lu121314/llama_acc/board/runtime/data/README.md

此目录有tokenizer、模型manifest及许可，不包含权重。
请将本版core0.bin和core1.bin放到这里；网盘信息填写在压缩包项目根目录的“权重下载地址.txt”。
