lu121314/llama_acc/report/zu7cg_llama_fpga_handoff.md

# ZU7CG Llama FPGA 项目续接提示词

请接续我的 ZU7CG 双核双DDR Llama FPGA 项目，按本次任务完成开发、验证或交付。先读取现有工程和证据，再行动；对已有授权自主推进，需要我决策时说明具体问题。

## 工作区与入口

- 工作区：`/mnt/data/llama_32_FPGA`。本次所有新文件、日志、补丁和工程都放在 `Version1/`。
- 首先读取：`/mnt/data/llama_32_FPGA/Version1/skills/zu7cg-llama-fpga/SKILL.md`，按任务选择其中的工程索引、硬件流程或PYNQ参考文件。
- 核对 `Version1/PROJECTS.md`、`Version1/vivado_prj/local_rebuild_20261031/current_projects.json`，并按任务检查目标工程的配置、manifest和独立验收记录。
- 上游参考：`llama-fpga/`；旧板级工程：`FPGA_prj/llama32_zu7cg/`；原模型导出/运行工程：`PYTHON_prj/`。保留这些参考。

## 当前基线

以下为截至2026-11-02的交接快照，执行时核对当前文件：

- 已有 Llama3.2-3B 的1024/8192上下文、187.5/250MHz四种版本，四份完整远端Vivado工程均已拷回本机；具体完整副本位置见Skill的工程索引。
- 标准Vivado入口位于 `Version1/vivado_prj/local_rebuild_20261031/`，命名示例为 `llama32_3b_ctx8192_250mhz`。两个1024标准入口与其完整远端副本目录不同，勿混淆。
- 两个8K版本已有接受的实现和配套bit/HWH；最终物理结果来自选定候选DCP。不要仅凭managed `impl_2` 的进度判定最终结果。
- 新8K版本尚未完成板端推理验证。旧版本的单次、重复文本日志不能替代新bit的板端验证。
- 8K权重已生成，两个时钟共用一套完整资源：`core0.bin`、`core1.bin`、模型manifest和tokenizer。每核镜像为2,063,458,304字节；原1024镜像不能直接用于8K布局。共享目录须在运行配置中正确引用。
- 早先复位/BOS排查有条件性V scale残留证据，后来普通文本重复测试也曾通过；唯一根因未闭合，候选修复未应用到生产源。查原始证据后再判断，不把猜测当成已修复或普遍失效。

## 必须遵守的修改约束

1. 保留现有模型、上下文、时钟版本和方案；不删除远端工程、候选、报告、日志。替换本机副本前保留旧目录。
2. 工程按 `模型_ctx上下文_时钟频率` 命名。尽量保持与上游LLaMA2加速器的结构一致，只做完成目标所需的修改。
3. 命名、目录重构、拷贝和纯时钟变体不改RTL逻辑。模型或上下文变更优先修改Scala并生成RTL，在独立变体中保持Scala、RTL、IP、内存布局、权重和运行配置一致。
4. 防过度防御：对几乎不会发生的边界/并发问题，先说明发生条件、概率依据或未知之处，经我确认后再加代码；严禁为了“理论上更稳”膨胀实现。已有实际接口约束和内存预留检查继续保留。
5. 按修改范围使用局部模块仿真与接口时序验证，不主动运行全加速器仿真。测试通过后进入本次任务所需的综合与实现，不无依据扩大验证或重复启动布局布线。
6. 查询、拷贝或打包现有合格结果时，使用已有结果；不要顺带启动新构建。时序通过后从已验收DCP生成bit，不再为重复确认重跑实现。
7. 保留远端快速创建工程脚本。远端凭据仅从 `Version1/Agent.md` 通过现有 `scripts/remote_session.py` 读取，不输出到日志、提示词或交付包。开始构建前检查服务器任务，不中断其他作业；读取日志超时不能直接认定后台作业失败或重复提交。
8. 用户通过板卡Jupyter终端手动执行命令；Vivado服务器不是板卡。给出可直接执行的终端命令，使用板卡现有PYNQ venv。完整部署已复制后的常规小更新优先提供补丁。

## 硬件验证与交付要求

- 先明确目标版本及必要差异，再验证受影响的接口、握手/背压、reset、tag/last、地址和计数；涉及浮点/FIFO IP时核对真实端口与延迟，说明仿真是否使用替身。
- 硬件变更通过局部验证后，才执行所需综合与布局布线。保留来源、脚本、日志和失败候选。
- 验收覆盖setup、hold、pulse、路由、DRC、bus skew及真实MIG MinSkew。当前配置需覆盖18组bus skew和22条Fast/Slow MinSkew；不得关闭检查或放宽约束制造通过。
- MinSkew等关键证据需在真实路由会话中采集并绑定DCP哈希；重开DCP后的空报告不能当成通过。自动CDC告警按实际路径复核，不伪称全部告警清零。
- bit、HWH、manifest须与同一接受结果配套。独立验收JSON与导出manifest分工不同，不手动翻转 `timing_verified` 代替验证。
- 完整工程回传需全文件清单/大小/哈希及本机Vivado引用检查。明确交付的是完整远端工程，还是XPR加DCP。

## PYNQ运行要求

- 既有板卡环境为PYNQ 4.0、Python 3.12.3、aarch64，常用解释器为 `/usr/local/share/pynq-venv/bin/python3`；先核对实际环境。离线依赖匹配该架构与版本。
- 日常运行打印关键步骤，用进度条和百分比显示权重上传；不做权重哈希与DDR回读。`test/` 保留带详细日志的诊断程序，允许其中保留传输校验；`tests/` 为主机测试。
- 保留终端Prompt/Chat、UI、多语言输入输出、最大输出调节和性能指标。区分权重初始化时间、首token延迟、总生成用时、decode速度与整体速度，不用包含权重上传的总耗时替代推理时间。
- 保留资源大小/布局、硬件配套和PS内存预留检查。PS模型池为 `0x800000000` 起的2GiB启动期独占 `no-map`，不能绕过检查向Linux使用的内存写入。
- 上下文预算包含模板、历史和当前输入；当前约束为 `输入token数 + max_new_tokens - 1 <= context_tokens`，不能只改UI限制宣称硬件扩容。
- 板端先短文本，再同进程重复相同prompt、两个不同prompt及所需长上下文覆盖。保存输入与输出token ID、首次不同位置和日志，区分软复位与重下载Overlay/权重。

## 完成标准

完成本次已授权范围，不仅给计划或宣布已提交后台任务。说明修改了什么、验证了什么、仍有哪些未验证结论；区分源代码、局部仿真、实现时序、文件交付和板端功能。

给出准确的本机绝对路径、运行命令或补丁应用命令，并更新对应工程索引和验证记录。关键阻塞或失败如实说明，不用旧日志代替新结果。

## 本次任务（使用前填写）

目标版本：〔模型 / 上下文 / 时钟〕

具体任务：〔需要完成的修改、验证、查询或交付〕

完成后交付：〔文件、工程、bit/HWH、报告或板端命令〕
