lu121314/llama_acc/src/rtl/compute/AddEngineNew_3.v

// Generator : SpinalHDL v1.10.2a    git head : a348a60b7e8b6a455c72e1536ec3d74a2ea16935
// Component : DataPath_xN

`timescale 1ns/1ps

module AddEngineNew_3 (
  input  wire          mulRes_tvalid,
  output wire          mulRes_tready,
  input  wire [511:0]  mulRes_tdata,
  input  wire          resAdd_tvalid,
  output wire          resAdd_tready,
  input  wire [511:0]  resAdd_tdata,
  output wire          vecOut_tvalid,
  output wire [511:0]  vecOut_tdata,
  output wire [5:0]    vecOut_tuser,
  output wire          scalarOut_tvalid,
  output wire          scalarOut_tlast,
  output wire [15:0]   scalarOut_tdata,
  output wire [5:0]    scalarOut_tuser,
  input  wire          cfg_tvalid,
  output wire          cfg_tready,
  input  wire [31:0]   cfg_tdata,
  output wire [5:0]    postCfgTag,
  input  wire          popVldNext,
  input  wire          clk_1_clk,
  input  wire          clk_1_resetn
);

  wire                fifoCtrl_io_push_valid;
  wire       [511:0]  fifoCtrl_io_push_payload;
  wire                fifoCtrl_io_pop_ready;
  wire       [511:0]  fifoCtrl_rdPort_rsp;
  reg        [511:0]  t_1_spinal_port1;
  wire                fifoCtrl_io_push_ready;
  wire                fifoCtrl_io_pop_valid;
  wire       [511:0]  fifoCtrl_io_pop_payload;
  wire       [5:0]    fifoCtrl_io_occupancy;
  wire       [5:0]    fifoCtrl_io_availability;
  wire                fifoCtrl_rdPort_cmd_valid;
  wire       [4:0]    fifoCtrl_rdPort_cmd_payload;
  wire                fifoCtrl_wrPort_valid;
  wire       [4:0]    fifoCtrl_wrPort_payload_address;
  wire       [511:0]  fifoCtrl_wrPort_payload_data;
  wire                addLogic_a_0_add_ip_m_axis_result_tvalid;
  wire       [15:0]   addLogic_a_0_add_ip_m_axis_result_tdata;
  wire                addLogic_a_1_add_ip_m_axis_result_tvalid;
  wire       [15:0]   addLogic_a_1_add_ip_m_axis_result_tdata;
  wire                addLogic_a_2_add_ip_m_axis_result_tvalid;
  wire       [15:0]   addLogic_a_2_add_ip_m_axis_result_tdata;
  wire                addLogic_a_3_add_ip_m_axis_result_tvalid;
  wire       [15:0]   addLogic_a_3_add_ip_m_axis_result_tdata;
  wire                addLogic_a_4_add_ip_m_axis_result_tvalid;
  wire       [15:0]   addLogic_a_4_add_ip_m_axis_result_tdata;
  wire                addLogic_a_5_add_ip_m_axis_result_tvalid;
  wire       [15:0]   addLogic_a_5_add_ip_m_axis_result_tdata;
  wire                addLogic_a_6_add_ip_m_axis_result_tvalid;
  wire       [15:0]   addLogic_a_6_add_ip_m_axis_result_tdata;
  wire                addLogic_a_7_add_ip_m_axis_result_tvalid;
  wire       [15:0]   addLogic_a_7_add_ip_m_axis_result_tdata;
  wire                addLogic_a_8_add_ip_m_axis_result_tvalid;
  wire       [15:0]   addLogic_a_8_add_ip_m_axis_result_tdata;
  wire                addLogic_a_9_add_ip_m_axis_result_tvalid;
  wire       [15:0]   addLogic_a_9_add_ip_m_axis_result_tdata;
  wire                addLogic_a_10_add_ip_m_axis_result_tvalid;
  wire       [15:0]   addLogic_a_10_add_ip_m_axis_result_tdata;
  wire                addLogic_a_11_add_ip_m_axis_result_tvalid;
  wire       [15:0]   addLogic_a_11_add_ip_m_axis_result_tdata;
  wire                addLogic_a_12_add_ip_m_axis_result_tvalid;
  wire       [15:0]   addLogic_a_12_add_ip_m_axis_result_tdata;
  wire                addLogic_a_13_add_ip_m_axis_result_tvalid;
  wire       [15:0]   addLogic_a_13_add_ip_m_axis_result_tdata;
  wire                addLogic_a_14_add_ip_m_axis_result_tvalid;
  wire       [15:0]   addLogic_a_14_add_ip_m_axis_result_tdata;
  wire                addLogic_a_15_add_ip_m_axis_result_tvalid;
  wire       [15:0]   addLogic_a_15_add_ip_m_axis_result_tdata;
  wire                addLogic_a_16_add_ip_m_axis_result_tvalid;
  wire       [15:0]   addLogic_a_16_add_ip_m_axis_result_tdata;
  wire                addLogic_a_17_add_ip_m_axis_result_tvalid;
  wire       [15:0]   addLogic_a_17_add_ip_m_axis_result_tdata;
  wire                addLogic_a_18_add_ip_m_axis_result_tvalid;
  wire       [15:0]   addLogic_a_18_add_ip_m_axis_result_tdata;
  wire                addLogic_a_19_add_ip_m_axis_result_tvalid;
  wire       [15:0]   addLogic_a_19_add_ip_m_axis_result_tdata;
  wire                addLogic_a_20_add_ip_m_axis_result_tvalid;
  wire       [15:0]   addLogic_a_20_add_ip_m_axis_result_tdata;
  wire                addLogic_a_21_add_ip_m_axis_result_tvalid;
  wire       [15:0]   addLogic_a_21_add_ip_m_axis_result_tdata;
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
  reg                 dotCtrl_accCntOvf_delay_20;
  reg                 dotCtrl_accCntOvf_delay_21;
  reg                 dotCtrl_accCntOvf_delay_22;
  reg                 dotCtrl_accCntOvf_delay_23;
  reg                 dotCtrl_accCntOvf_delay_24;
  reg                 dotCtrl_accCntOvf_delay_25;
  reg                 dotCtrl_accCntOvf_delay_26;
  reg                 dotCtrl_accCntOvf_delay_27;
  reg                 dotCtrl_accCntOvf_delay_28;
  reg                 dotCtrl_accCntOvf_delay_29;
  reg                 dotCtrl_accCntOvf_delay_30;
  reg                 dotCtrl_accCntOvf_delay_31;
  reg                 dotCtrl_accCntOvf_delay_32;
  reg                 dotCtrl_accCntOvf_delay_33;
  reg                 dotCtrl_accCntOvf_delay_34;
  reg                 dotCtrl_accCntOvf_delay_35;
  reg                 dotCtrl_accCntOvfDly;
  reg                 dotCtrl_accCntOvf_delay_1_1;
  reg                 dotCtrl_accCntOvf_delay_2_1;
  reg                 dotCtrl_accCntOvf_delay_3_1;
  reg                 dotCtrl_accCntOvf_delay_4_1;
  reg                 dotCtrl_accCntOvf_delay_5_1;
  reg                 dotCtrl_accCntOvf_delay_6_1;
  reg                 dotCtrl_accCntOvf_delay_7_1;
  reg                 dotCtrl_accCntOvf_delay_8_1;
  reg                 dotCtrl_accCntOvf_delay_9_1;
  reg                 dotCtrl_accCntOvf_delay_10_1;
  reg                 dotCtrl_accCntOvf_delay_11_1;
  reg                 dotCtrl_accCntOvf_delay_12_1;
  reg                 dotCtrl_accCntOvf_delay_13_1;
  reg                 dotCtrl_accCntOvf_delay_14_1;
  reg                 dotCtrl_accCntOvf_delay_15_1;
  reg                 dotCtrl_accCntOvf_delay_16_1;
  reg                 dotCtrl_accCntOvf_delay_17_1;
  reg                 dotCtrl_accCntOvf_delay_18_1;
  reg                 dotCtrl_accCntOvf_delay_19_1;
  reg                 dotCtrl_accCntOvf_delay_20_1;
  reg                 dotCtrl_accCntOvf_delay_21_1;
  reg                 dotCtrl_accCntOvf_delay_22_1;
  reg                 dotCtrl_accCntOvf_delay_23_1;
  reg                 dotCtrl_accCntOvf_delay_24_1;
  reg                 dotCtrl_accCntOvf_delay_25_1;
  reg                 dotCtrl_accCntOvf_delay_26_1;
  reg                 dotCtrl_accCntOvf_delay_27_1;
  reg                 dotCtrl_accCntOvf_delay_28_1;
  reg                 dotCtrl_accCntOvf_delay_29_1;
  reg                 dotCtrl_accCntOvf_delay_30_1;
  reg        [31:0]   fAxpyCtrl_cfgPayload;
  (* max_fanout = 100 *) reg                 fAxpyCtrl_cfgVld;
  wire                fAxpyCtrl_psumPopEn;
  wire                fAxpyCtrl_psumPushEn;
  wire                fAxpyCtrl_enMulResCntNext;
  reg                 fAxpyCtrl_enMulResCnt;
  reg        [6:0]    fAxpyCtrl_muResCnt_0;
  reg        [16:0]   fAxpyCtrl_muResCnt_1;
  reg                 fAxpyCtrl_mulResCntOvf_0;
  reg                 fAxpyCtrl_mulResCntOvf_1;
  reg                 fAxpyCtrl_mulResCntOvfReduce;
  reg        [6:0]    t_fAxpyCtrl_muResCnt_0;
  reg        [16:0]   t_fAxpyCtrl_muResCnt_1;
  wire                t_fAxpyCtrl_mulResCntOvf_0;
  wire                t_fAxpyCtrl_mulResCntOvf_1;
  reg                 fAxpyCtrl_mulResCntLastZero;
  reg                 fAxpyCtrl_mulResCntLastZeroNext;
  reg                 fAxpyCtrl_mulResCntLastNotZero;
  reg                 fAxpyCtrl_mulResCntLastNotZeroNext;
  reg                 fAxpyCtrl_enMulResCnt_delay_1;
  reg                 fAxpyCtrl_enMulResCnt_delay_2;
  reg                 fAxpyCtrl_enMulResCnt_delay_3;
  reg                 fAxpyCtrl_enMulResCnt_delay_4;
  reg                 fAxpyCtrl_enMulResCnt_delay_5;
  reg                 fAxpyCtrl_enAddOutCnt;
  reg                 fAxpyCtrl_mulResCntOvf_0_delay_1;
  reg                 fAxpyCtrl_mulResCntOvf_0_delay_2;
  reg                 fAxpyCtrl_mulResCntOvf_0_delay_3;
  reg                 fAxpyCtrl_mulResCntOvf_0_delay_4;
  reg                 fAxpyCtrl_mulResCntOvf_0_delay_5;
  reg                 fAxpyCtrl_addOutCntOvf_0;
  reg                 fAxpyCtrl_mulResCntOvf_1_delay_1;
  reg                 fAxpyCtrl_mulResCntOvf_1_delay_2;
  reg                 fAxpyCtrl_mulResCntOvf_1_delay_3;
  reg                 fAxpyCtrl_mulResCntOvf_1_delay_4;
  reg                 fAxpyCtrl_mulResCntOvf_1_delay_5;
  reg                 fAxpyCtrl_addOutCntOvf_1;
  reg                 t_fAxpyCtrl_psumPushEnReg;
  reg                 t_fAxpyCtrl_psumPushEnReg_1;
  reg                 t_fAxpyCtrl_psumPushEnReg_2;
  reg                 t_fAxpyCtrl_psumPushEnReg_3;
  reg                 t_fAxpyCtrl_psumPushEnReg_4;
  reg                 fAxpyCtrl_psumPushEnReg;
  reg                 fAxpyCtrl_resAddReady;
  wire                fAxpyCtrl_resAddReadyNext;
  reg                 fAxpyCtrl_psumPopEnReg;
  wire                fAxpyCtrl_psumPopEnRegNext;
  wire       [1:0]    fAxpyCtrl_aSelNext;
  reg        [1:0]    fAxpyCtrl_bSelNext;
  wire                fAxpyCtrl_vecOutVld;
  reg        [31:0]   pAxpyCtrl_cfgPayload;
  (* max_fanout = 100 *) reg                 pAxpyCtrl_cfgVld;
  reg                 pAxpyCtrl_cycleReduce;
  reg                 pAxpyCtrl_cycleReduceNext;
  reg                 pAxpyCtrl_cycleReduceDly;
  wire                pAxpyCtrl_enMulResCntNext;
  reg                 pAxpyCtrl_enMulResCnt;
  reg        [15:0]   pAxpyCtrl_mulResCnt;
  reg        [15:0]   pAxpyCtrl_mulResCntNext;
  wire       [2:0]    pAxpyCtrl_mulResCntLow;
  wire       [12:0]   pAxpyCtrl_mulResCntHigh;
  reg                 pAxpyCtrl_mulResCntOvf;
  wire                pAxpyCtrl_mulResCntOvfNext;
  reg                 pAxpyCtrl_mulResCntHighZero;
  reg                 pAxpyCtrl_mulResCntHighZeroNext;
  reg                 pAxpyCtrl_mulResCntHighNotZero;
  reg                 pAxpyCtrl_mulResCntHighNotZeroNext;
  reg                 pAxpyCtrl_enMulResCnt_delay_1;
  reg                 pAxpyCtrl_enMulResCnt_delay_2;
  reg                 pAxpyCtrl_enMulResCnt_delay_3;
  reg                 pAxpyCtrl_enMulResCnt_delay_4;
  reg                 pAxpyCtrl_enMulResCnt_delay_5;
  reg                 pAxpyCtrl_enMulResCntDly;
  wire                pAxpyCtrl_enAddOutCnt;
  reg                 pAxpyCtrl_mulResCntOvf_delay_1;
  reg                 pAxpyCtrl_mulResCntOvf_delay_2;
  reg                 pAxpyCtrl_mulResCntOvf_delay_3;
  reg                 pAxpyCtrl_mulResCntOvf_delay_4;
  reg                 pAxpyCtrl_mulResCntOvf_delay_5;
  reg                 pAxpyCtrl_addOutCntOvf;
  wire                pAxpyCtrl_reduceVldDly;
  wire                pAxpyCtrl_enCycleCnt;
  reg        [2:0]    pAxpyCtrl_cycleCnt;
  reg        [2:0]    pAxpyCtrl_cycleCntNext;
  (* max_fanout = 100 *) reg                 pAxpyCtrl_lastElem;
  wire       [2:0]    t_pAxpyCtrl_lastElemNext;
  wire       [16:0]   t_pAxpyCtrl_lastElemNext_1;
  wire                pAxpyCtrl_lastElemNext;
  wire                pAxpyCtrl_psumPushEn;
  reg                 pAxpyCtrl_psumPopEn;
  reg                 pAxpyCtrl_psumPopEnNext;
  wire       [1:0]    pAxpyCtrl_aSelNext;
  wire       [1:0]    pAxpyCtrl_bSelNext;
  reg                 pAxpyCtrl_bSelBit;
  wire                pAxpyCtrl_bSelBitNext;
  wire                pAxpyCtrl_flagClrCond;
  reg                 pAxpyCtrl_flagSetCond;
  reg                 pAxpyCtrl_flagInv;
  reg                 pAxpyCtrl_flagInvNext;
  reg                 pAxpyCtrl_vldToggle;
  wire                add_fifoCtrl_io_pop_fire;
  wire                pAxpyCtrl_reduceVld;
  reg                 pAxpyCtrl_psumVld;
  reg                 t_pAxpyCtrl_reduceVldDly;
  reg                 t_pAxpyCtrl_reduceVldDly_1;
  reg                 t_pAxpyCtrl_reduceVldDly_2;
  reg                 t_pAxpyCtrl_reduceVldDly_3;
  reg                 t_pAxpyCtrl_reduceVldDly_4;
  reg                 t_pAxpyCtrl_reduceVldDly_5;
  wire                pAxpyCtrl_vecOutVld;
  wire       [2:0]    selVldNextOneHot;
  wire                t_selVldNextUInt;
  wire                t_selVldNextUInt_1;
  wire       [1:0]    selVldNextUInt;
  reg        [1:0]    selVldUIntReg;
  (* keep = "true" *) reg        [1:0]    selFifoPushUInt;
  (* keep = "true" *) reg        [1:0]    selFifoPopUInt;
  (* max_fanout = 100 *) reg        [1:0]    aSel;
  (* max_fanout = 100 *) reg        [1:0]    bSel;
  wire       [1:0]    aSelNext;
  wire       [1:0]    bSelNext;
  (* max_fanout = 100 *) reg                 ready;
  reg                 readyNext;
  (* ram_style = "distributed" *) reg [511:0] t_1 [0:31];

  assign t_when = (&pAxpyCtrl_mulResCntLow);
  assign t_dotCtrl_accCntOvf = {2'd0, dotCtrl_accCnt};
  assign t_pAxpyCtrl_mulResCntOvfNext = {1'd0, pAxpyCtrl_mulResCntNext};
  assign t_pAxpyCtrl_lastElemNext_2 = {14'd0, pAxpyCtrl_cycleCntNext};
  assign t_pAxpyCtrl_lastElemNext_3 = {14'd0, t_pAxpyCtrl_lastElemNext};
  assign t_pAxpyCtrl_lastElemNext_4 = {14'd0, t_pAxpyCtrl_lastElemNext};
  assign t_io_push_payload = {addLogic_vecOut_15,{addLogic_vecOut_14,{addLogic_vecOut_13,{addLogic_vecOut_12,{addLogic_vecOut_11,{addLogic_vecOut_10,{addLogic_vecOut_9,{addLogic_vecOut_8,{addLogic_vecOut_7,{addLogic_vecOut_6,{addLogic_vecOut_5,{addLogic_vecOut_4,{addLogic_vecOut_3,{addLogic_vecOut_2,{addLogic_vecOut_1,addLogic_vecOut_0}}}}}}}}}}}}}}};
  assign t_vecOut_tdata = {addLogic_vecOut_15,{addLogic_vecOut_14,{addLogic_vecOut_13,{addLogic_vecOut_12,{addLogic_vecOut_11,{addLogic_vecOut_10,{addLogic_vecOut_9,{addLogic_vecOut_8,{addLogic_vecOut_7,{addLogic_vecOut_6,{addLogic_vecOut_5,{addLogic_vecOut_4,{addLogic_vecOut_3,{addLogic_vecOut_2,{addLogic_vecOut_1,addLogic_vecOut_0}}}}}}}}}}}}}}};
  always @(posedge clk_1_clk) begin
    if(fifoCtrl_wrPort_valid) begin
      t_1[fifoCtrl_wrPort_payload_address] <= fifoCtrl_wrPort_payload_data;
    end
  end

  always @(posedge clk_1_clk) begin
    if(fifoCtrl_rdPort_cmd_valid) begin
      t_1_spinal_port1 <= t_1[fifoCtrl_rdPort_cmd_payload];
    end
  end

  StreamFifoCtrl_3 fifoCtrl (
    .io_push_valid          (fifoCtrl_io_push_valid              ), //i
    .io_push_ready          (fifoCtrl_io_push_ready              ), //o
    .io_push_payload        (fifoCtrl_io_push_payload[511:0]     ), //i
    .io_pop_valid           (fifoCtrl_io_pop_valid               ), //o
    .io_pop_ready           (fifoCtrl_io_pop_ready               ), //i
    .io_pop_payload         (fifoCtrl_io_pop_payload[511:0]      ), //o
    .io_flush               (1'b0                                ), //i
    .io_occupancy           (fifoCtrl_io_occupancy[5:0]          ), //o
    .io_availability        (fifoCtrl_io_availability[5:0]       ), //o
    .rdPort_cmd_valid       (fifoCtrl_rdPort_cmd_valid           ), //o
    .rdPort_cmd_payload     (fifoCtrl_rdPort_cmd_payload[4:0]    ), //o
    .rdPort_rsp             (fifoCtrl_rdPort_rsp[511:0]          ), //i
    .wrPort_valid           (fifoCtrl_wrPort_valid               ), //o
    .wrPort_payload_address (fifoCtrl_wrPort_payload_address[4:0]), //o
    .wrPort_payload_data    (fifoCtrl_wrPort_payload_data[511:0] ), //o
    .clk_1_clk              (clk_1_clk                           ), //i
    .clk_1_resetn           (clk_1_resetn                        )  //i
  );
  fp16add6 addLogic_a_0_add_ip (
    .aclk                 (clk_1_clk                                    ), //i
    .s_axis_a_tvalid      (addLogic_a_0_valid                           ), //i
    .s_axis_a_tdata       (addLogic_a_0_payload[15:0]                   ), //i
    .s_axis_b_tvalid      (addLogic_b_0_valid                           ), //i
    .s_axis_b_tdata       (addLogic_b_0_payload[15:0]                   ), //i
    .m_axis_result_tvalid (addLogic_a_0_add_ip_m_axis_result_tvalid     ), //o
    .m_axis_result_tdata  (addLogic_a_0_add_ip_m_axis_result_tdata[15:0])  //o
  );
  fp16add6 addLogic_a_1_add_ip (
    .aclk                 (clk_1_clk                                    ), //i
    .s_axis_a_tvalid      (addLogic_a_1_valid                           ), //i
    .s_axis_a_tdata       (addLogic_a_1_payload[15:0]                   ), //i
    .s_axis_b_tvalid      (addLogic_b_1_valid                           ), //i
    .s_axis_b_tdata       (addLogic_b_1_payload[15:0]                   ), //i
    .m_axis_result_tvalid (addLogic_a_1_add_ip_m_axis_result_tvalid     ), //o
    .m_axis_result_tdata  (addLogic_a_1_add_ip_m_axis_result_tdata[15:0])  //o
  );
  fp16add6 addLogic_a_2_add_ip (
    .aclk                 (clk_1_clk                                    ), //i
    .s_axis_a_tvalid      (addLogic_a_2_valid                           ), //i
    .s_axis_a_tdata       (addLogic_a_2_payload[15:0]                   ), //i
    .s_axis_b_tvalid      (addLogic_b_2_valid                           ), //i
    .s_axis_b_tdata       (addLogic_b_2_payload[15:0]                   ), //i
    .m_axis_result_tvalid (addLogic_a_2_add_ip_m_axis_result_tvalid     ), //o
    .m_axis_result_tdata  (addLogic_a_2_add_ip_m_axis_result_tdata[15:0])  //o
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
        t_addLogic_b_11_payload = addLogic_zero;
        t_addLogic_b_12_payload = addLogic_zero;
        t_addLogic_b_13_payload = addLogic_zero;
        t_addLogic_b_14_payload = addLogic_zero;
        t_addLogic_b_15_payload = addLogic_zero;
        t_addLogic_b_16_payload = addLogic_zero;
        t_addLogic_b_17_payload = addLogic_zero;
        t_addLogic_b_18_payload = addLogic_zero;
        t_addLogic_b_19_payload = addLogic_zero;
        t_addLogic_b_20_payload = addLogic_zero;
        t_addLogic_b_21_payload = addLogic_zero;
        t_addLogic_b_22_payload = addLogic_zero;
        t_addLogic_b_23_payload = addLogic_zero;
        t_addLogic_b_24_payload = addLogic_zero;
        t_addLogic_b_25_payload = addLogic_zero;
        t_addLogic_b_26_payload = addLogic_zero;
        t_addLogic_b_27_payload = addLogic_zero;
        t_addLogic_b_28_payload = addLogic_zero;
        t_addLogic_b_29_payload = addLogic_zero;
        t_addLogic_b_30_payload = addLogic_zero;
        t_addLogic_b_31_payload = addLogic_zero;
      end
    endcase
  end

  always @(*) begin
    case(selFifoPushUInt)
      2'b00 : t_io_push_valid = 1'b0;
      2'b01 : t_io_push_valid = fAxpyCtrl_psumPushEn;
      default : t_io_push_valid = pAxpyCtrl_psumPushEn;
    endcase
  end

  always @(*) begin
    case(selFifoPopUInt)
      2'b00 : t_io_pop_ready = 1'b0;
      2'b01 : t_io_pop_ready = fAxpyCtrl_psumPopEn;
      default : t_io_pop_ready = pAxpyCtrl_psumPopEn;
    endcase
  end

  always @(*) begin
    case(selVldNextUInt)
      2'b00 : begin
        t_aSelNext = dotCtrl_aSelNext;
        t_bSelNext = dotCtrl_bSelNext;
      end
      2'b01 : begin
        t_aSelNext = fAxpyCtrl_aSelNext;
        t_bSelNext = fAxpyCtrl_bSelNext;
      end
      default : begin
        t_aSelNext = pAxpyCtrl_aSelNext;
        t_bSelNext = pAxpyCtrl_bSelNext;
      end
    endcase
  end

  assign tag = cfg_tdata[31 : 26];
  assign dotCond = (! cfg_tdata[24]);
  assign fAxpyCond = (cfg_tdata[24] && (cfg_tdata[22 : 16] != 7'h0));
  assign pAxpyCond = (cfg_tdata[24] && (cfg_tdata[22 : 16] == 7'h0));
  always @(*) begin
    ret_0_valid = (cfg_tvalid && dotCond);
    if(ret_0_ready) begin
      ret_0_valid = 1'b0;
    end
  end

  assign ret_0_payload = cfg_tdata;
  always @(*) begin
    ret_1_valid = (cfg_tvalid && fAxpyCond);
    if(ret_1_ready) begin
      ret_1_valid = 1'b0;
    end
  end

  assign ret_1_payload = cfg_tdata;
  always @(*) begin
    ret_2_valid = (cfg_tvalid && pAxpyCond);
    if(ret_2_ready) begin
      ret_2_valid = 1'b0;
    end
  end

  assign ret_2_payload = cfg_tdata;
  assign cfg_tready = (|{(ret_2_ready && pAxpyCond),{(ret_1_ready && fAxpyCond),(ret_0_ready && dotCond)}});
  assign fifoCtrl_rdPort_rsp = t_1_spinal_port1;
  assign addLogic_zero = 16'h0;
  assign addLogic_mul_0 = mulRes_tdata[15 : 0];
  assign addLogic_mul_1 = mulRes_tdata[31 : 16];
  assign addLogic_mul_2 = mulRes_tdata[47 : 32];
  assign addLogic_mul_3 = mulRes_tdata[63 : 48];
  assign addLogic_mul_4 = mulRes_tdata[79 : 64];
  assign addLogic_mul_5 = mulRes_tdata[95 : 80];
  assign addLogic_mul_6 = mulRes_tdata[111 : 96];
  assign addLogic_mul_7 = mulRes_tdata[127 : 112];
  assign addLogic_mul_8 = mulRes_tdata[143 : 128];
  assign addLogic_mul_9 = mulRes_tdata[159 : 144];
  assign addLogic_mul_10 = mulRes_tdata[175 : 160];
  assign addLogic_mul_11 = mulRes_tdata[191 : 176];
  assign addLogic_mul_12 = mulRes_tdata[207 : 192];
  assign addLogic_mul_13 = mulRes_tdata[223 : 208];
  assign addLogic_mul_14 = mulRes_tdata[239 : 224];
  assign addLogic_mul_15 = mulRes_tdata[255 : 240];
  assign addLogic_mul_16 = mulRes_tdata[271 : 256];
  assign addLogic_mul_17 = mulRes_tdata[287 : 272];
  assign addLogic_mul_18 = mulRes_tdata[303 : 288];
  assign addLogic_mul_19 = mulRes_tdata[319 : 304];
  assign addLogic_mul_20 = mulRes_tdata[335 : 320];
  assign addLogic_mul_21 = mulRes_tdata[351 : 336];
  assign addLogic_mul_22 = mulRes_tdata[367 : 352];
  assign addLogic_mul_23 = mulRes_tdata[383 : 368];
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
  assign dotCtrl_aSelNext = 2'b01;
  assign dotCtrl_bSelNext = 2'b01;
  assign dotCtrl_enMulResCntNext = (mulResFireNext && ret_0_valid);
  assign t_dotCtrl_mulResCntOvf_0 = (t_dotCtrl_muResCnt_0 == ret_0_payload[22 : 16]);
  assign t_dotCtrl_mulResCntOvf_1 = (t_dotCtrl_muResCnt_1 == {ret_0_payload[23],ret_0_payload[15 : 0]});
  always @(*) begin
    t_dotCtrl_muResCnt_0 = dotCtrl_muResCnt_0;
    if(dotCtrl_enMulResCnt) begin
      t_dotCtrl_muResCnt_0 = (dotCtrl_muResCnt_0 + 7'h01);
      if(dotCtrl_mulResCntOvf_0) begin
        t_dotCtrl_muResCnt_0 = 7'h0;
      end
    end
  end

  always @(*) begin
    t_dotCtrl_muResCnt_1 = dotCtrl_muResCnt_1;
    if(dotCtrl_enMulResCnt) begin
      if(dotCtrl_mulResCntOvf_0) begin
        t_dotCtrl_muResCnt_1 = (dotCtrl_muResCnt_1 + 17'h00001);
        if(dotCtrl_mulResCntOvf_1) begin
          t_dotCtrl_muResCnt_1 = 17'h0;
        end
      end
    end
  end

  assign dotCtrl_flagClrCond = (dotCtrl_enMulResCnt && dotCtrl_mulResCntOvfReduce);
  always @(*) begin
    dotCtrl_flagInvNext = dotCtrl_flagInv;
    if(dotCtrl_flagClrCond) begin
      dotCtrl_flagInvNext = 1'b0;
    end
    if(dotCtrl_flagSetCond) begin
      dotCtrl_flagInvNext = 1'b1;
    end
  end

  assign dotCtrl_accCntOvf = (t_dotCtrl_accCntOvf == dotCtrl_cfgPayload[22 : 16]);
  assign scalarOut_tvalid = dotCtrl_enAddOutCnt;
  assign scalarOut_tdata = addLogic_scalarOut;
  assign scalarOut_tuser = tag;
  assign scalarOut_tlast = dotCtrl_accCntOvf_delay_30_1;
  assign ret_0_ready = (dotCtrl_enAddOutCnt && (dotCtrl_addOutCntOvf_0 && dotCtrl_addOutCntOvf_1));
  assign postCfgTag = dotCtrl_cfgPayload[31 : 26];
  assign fAxpyCtrl_enMulResCntNext = (mulResFireNext && ret_1_valid);
  assign t_fAxpyCtrl_mulResCntOvf_0 = (t_fAxpyCtrl_muResCnt_0 == ret_1_payload[22 : 16]);
  assign t_fAxpyCtrl_mulResCntOvf_1 = (t_fAxpyCtrl_muResCnt_1 == {ret_1_payload[23],ret_1_payload[15 : 0]});
  always @(*) begin
    t_fAxpyCtrl_muResCnt_0 = fAxpyCtrl_muResCnt_0;
    if(fAxpyCtrl_enMulResCnt) begin
      t_fAxpyCtrl_muResCnt_0 = (fAxpyCtrl_muResCnt_0 + 7'h01);
      if(fAxpyCtrl_mulResCntOvf_0) begin
        t_fAxpyCtrl_muResCnt_0 = 7'h0;
      end
    end
  end

  always @(*) begin
    t_fAxpyCtrl_muResCnt_1 = fAxpyCtrl_muResCnt_1;
    if(fAxpyCtrl_enMulResCnt) begin
      if(fAxpyCtrl_mulResCntOvf_0) begin
        t_fAxpyCtrl_muResCnt_1 = (fAxpyCtrl_muResCnt_1 + 17'h00001);
        if(fAxpyCtrl_mulResCntOvf_1) begin
          t_fAxpyCtrl_muResCnt_1 = 17'h0;
        end
      end
    end
  end

  always @(*) begin
    fAxpyCtrl_mulResCntLastZeroNext = fAxpyCtrl_mulResCntLastZero;
    if(fAxpyCtrl_enMulResCnt) begin
      if(fAxpyCtrl_mulResCntOvf_0) begin
        fAxpyCtrl_mulResCntLastZeroNext = 1'b0;
        if(fAxpyCtrl_mulResCntOvf_1) begin
          fAxpyCtrl_mulResCntLastZeroNext = 1'b1;
        end
      end
    end
  end

  always @(*) begin
    fAxpyCtrl_mulResCntLastNotZeroNext = fAxpyCtrl_mulResCntLastNotZero;
    if(fAxpyCtrl_enMulResCnt) begin
      if(fAxpyCtrl_mulResCntOvf_0) begin
        fAxpyCtrl_mulResCntLastNotZeroNext = 1'b1;
        if(fAxpyCtrl_mulResCntOvf_1) begin
          fAxpyCtrl_mulResCntLastNotZeroNext = 1'b0;
        end
      end
    end
  end

  assign fAxpyCtrl_psumPushEn = fAxpyCtrl_psumPushEnReg;
  assign fAxpyCtrl_resAddReadyNext = ((fAxpyCtrl_enMulResCntNext && fAxpyCtrl_mulResCntLastZeroNext) && ret_1_payload[25]);
  assign resAdd_tready = fAxpyCtrl_resAddReady;
  assign fAxpyCtrl_psumPopEnRegNext = (fAxpyCtrl_enMulResCntNext && fAxpyCtrl_mulResCntLastNotZeroNext);
  assign fAxpyCtrl_psumPopEn = fAxpyCtrl_psumPopEnReg;
  assign fAxpyCtrl_aSelNext = 2'b00;
  always @(*) begin
    fAxpyCtrl_bSelNext = 2'b11;
    if(fAxpyCtrl_resAddReadyNext) begin
      fAxpyCtrl_bSelNext = 2'b10;
    end
    if(fAxpyCtrl_psumPopEnRegNext) begin
      fAxpyCtrl_bSelNext = 2'b00;
    end
  end

  assign ret_1_ready = (fAxpyCtrl_enMulResCnt && fAxpyCtrl_mulResCntOvfReduce);
  assign fAxpyCtrl_vecOutVld = (fAxpyCtrl_enAddOutCnt && fAxpyCtrl_addOutCntOvf_1);
  always @(*) begin
    pAxpyCtrl_cycleReduceNext = pAxpyCtrl_cycleReduce;
    if(pAxpyCtrl_enMulResCnt) begin
      if(pAxpyCtrl_mulResCntOvf) begin
        pAxpyCtrl_cycleReduceNext = 1'b1;
      end
    end
    if(pAxpyCtrl_enCycleCnt) begin
      if(pAxpyCtrl_lastElem) begin
        pAxpyCtrl_cycleReduceNext = 1'b0;
      end
    end
  end

  assign pAxpyCtrl_enMulResCntNext = (mulResFireNext && ret_2_valid);
  assign pAxpyCtrl_mulResCntLow = pAxpyCtrl_mulResCnt[2 : 0];
  assign pAxpyCtrl_mulResCntHigh = pAxpyCtrl_mulResCnt[15 : 3];
  assign pAxpyCtrl_mulResCntOvfNext = (t_pAxpyCtrl_mulResCntOvfNext == {ret_2_payload[23],ret_2_payload[15 : 0]});
  always @(*) begin
    pAxpyCtrl_mulResCntHighZeroNext = pAxpyCtrl_mulResCntHighZero;
    if(pAxpyCtrl_enMulResCnt) begin
      if(t_when) begin
        pAxpyCtrl_mulResCntHighZeroNext = 1'b0;
      end
    end
    if(pAxpyCtrl_enMulResCnt) begin
      if(pAxpyCtrl_mulResCntOvf) begin
        pAxpyCtrl_mulResCntHighZeroNext = 1'b1;
      end
    end
  end

  always @(*) begin
    pAxpyCtrl_mulResCntHighNotZeroNext = pAxpyCtrl_mulResCntHighNotZero;
    if(pAxpyCtrl_enMulResCnt) begin
      if(t_when) begin
        pAxpyCtrl_mulResCntHighNotZeroNext = 1'b1;
      end
    end
    if(pAxpyCtrl_enMulResCnt) begin
      if(pAxpyCtrl_mulResCntOvf) begin
        pAxpyCtrl_mulResCntHighNotZeroNext = 1'b0;
      end
    end
  end

  always @(*) begin
    pAxpyCtrl_mulResCntNext = pAxpyCtrl_mulResCnt;
    if(pAxpyCtrl_enMulResCnt) begin
      pAxpyCtrl_mulResCntNext = (pAxpyCtrl_mulResCnt + 16'h0001);
      if(pAxpyCtrl_mulResCntOvf) begin
        pAxpyCtrl_mulResCntNext = 16'h0;
      end
    end
  end

  assign pAxpyCtrl_enAddOutCnt = (pAxpyCtrl_enMulResCntDly && (! pAxpyCtrl_cycleReduceDly));
  assign pAxpyCtrl_enCycleCnt = (pAxpyCtrl_cycleReduceDly && pAxpyCtrl_reduceVldDly);
  assign t_pAxpyCtrl_lastElemNext = 3'b110;
  assign t_pAxpyCtrl_lastElemNext_1 = ({ret_2_payload[23],ret_2_payload[15 : 0]} - 17'h00001);
  assign pAxpyCtrl_lastElemNext = (t_pAxpyCtrl_lastElemNext_2 == ((t_pAxpyCtrl_lastElemNext_3 < t_pAxpyCtrl_lastElemNext_1) ? t_pAxpyCtrl_lastElemNext_4 : t_pAxpyCtrl_lastElemNext_1));
  always @(*) begin
    pAxpyCtrl_cycleCntNext = pAxpyCtrl_cycleCnt;
    if(pAxpyCtrl_enCycleCnt) begin
      pAxpyCtrl_cycleCntNext = (pAxpyCtrl_cycleCnt + 3'b001);
      if(pAxpyCtrl_lastElem) begin
        pAxpyCtrl_cycleCntNext = 3'b000;
      end
    end
  end

  assign pAxpyCtrl_psumPushEn = (pAxpyCtrl_cycleReduceDly ? (pAxpyCtrl_enCycleCnt && (! (pAxpyCtrl_enCycleCnt && pAxpyCtrl_lastElem))) : pAxpyCtrl_enMulResCntDly);
  always @(*) begin
    pAxpyCtrl_psumPopEnNext = 1'b0;
    if((pAxpyCtrl_enMulResCntNext && pAxpyCtrl_mulResCntHighNotZeroNext)) begin
      pAxpyCtrl_psumPopEnNext = 1'b1;
    end
    if(pAxpyCtrl_cycleReduceNext) begin
      pAxpyCtrl_psumPopEnNext = 1'b1;
    end
  end

  assign pAxpyCtrl_aSelNext = {pAxpyCtrl_cycleReduceNext,1'b0};
  assign pAxpyCtrl_bSelBitNext = (pAxpyCtrl_enMulResCntNext && pAxpyCtrl_mulResCntHighZeroNext);
  assign pAxpyCtrl_bSelNext = {pAxpyCtrl_bSelBitNext,pAxpyCtrl_bSelBitNext};
  assign pAxpyCtrl_flagClrCond = (pAxpyCtrl_enMulResCnt && pAxpyCtrl_mulResCntOvf);
  always @(*) begin
    pAxpyCtrl_flagInvNext = pAxpyCtrl_flagInv;
    if(pAxpyCtrl_flagClrCond) begin
      pAxpyCtrl_flagInvNext = 1'b0;
    end
    if(pAxpyCtrl_flagSetCond) begin
      pAxpyCtrl_flagInvNext = 1'b1;
    end
  end

  assign add_fifoCtrl_io_pop_fire = (fifoCtrl_io_pop_valid && fifoCtrl_io_pop_ready);
  assign pAxpyCtrl_reduceVld = (pAxpyCtrl_vldToggle && add_fifoCtrl_io_pop_fire);
  always @(*) begin
    pAxpyCtrl_psumVld = add_fifoCtrl_io_pop_fire;
    if(pAxpyCtrl_cycleReduce) begin
      pAxpyCtrl_psumVld = pAxpyCtrl_reduceVld;
    end
  end

  assign ret_2_ready = (pAxpyCtrl_enCycleCnt && pAxpyCtrl_lastElem);
  assign pAxpyCtrl_reduceVldDly = t_pAxpyCtrl_reduceVldDly_5;
  assign pAxpyCtrl_vecOutVld = ((pAxpyCtrl_cfgVld && pAxpyCtrl_enCycleCnt) && pAxpyCtrl_lastElem);
  assign vecOut_tvalid = (fAxpyCtrl_vecOutVld || pAxpyCtrl_vecOutVld);
  assign vecOut_tuser = (fAxpyCtrl_vecOutVld ? tagAddDly : tag);
  assign selVldNextOneHot = {{ret_2_valid,ret_1_valid},ret_0_valid};
  assign t_selVldNextUInt = selVldNextOneHot[1];
  assign t_selVldNextUInt_1 = selVldNextOneHot[2];
  assign selVldNextUInt = {t_selVldNextUInt_1,t_selVldNextUInt};
  assign fifoCtrl_io_push_valid = t_io_push_valid;
  assign fifoCtrl_io_pop_ready = t_io_pop_ready;
  assign aSelNext = t_aSelNext;
  assign bSelNext = t_bSelNext;
  assign addLogic_aSel = aSel;
  assign addLogic_bSel = bSel;
  always @(*) begin
    readyNext = 1'b0;
    if(ret_0_valid) begin
      readyNext = dotCtrl_flagInvNext;
    end
    if(ret_1_valid) begin
      readyNext = 1'b1;
    end
    if(ret_2_valid) begin
      readyNext = pAxpyCtrl_flagInvNext;
    end
  end
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
