lu121314/llama_acc/src/rtl/adapter/Parallel2Serial.v

// Generator : SpinalHDL v1.10.2a    git head : a348a60b7e8b6a455c72e1536ec3d74a2ea16935
// Component : DataPath_xN

`timescale 1ns/1ps

module Parallel2Serial (
  input  wire          io_input_valid,
  output wire          io_input_ready,
  input  wire [2047:0] io_input_tdata,
  input  wire [5:0]    io_input_tuser,
  output wire          io_output_valid,
  output wire [15:0]   io_output_tdata,
  output wire [5:0]    io_output_tuser,
  input  wire          clk_1_clk,
  input  wire          clk_1_resetn
);

  wire       [6:0]    t_t_output_payload_1;
  wire       [0:0]    t_t_output_payload_1_1;
  reg        [15:0]   t_output_payload_4;
  wire                input_valid;
  wire                input_ready;
  wire       [2047:0] input_payload;
  wire                output_valid;
  wire                output_ready;
  wire       [15:0]   output_payload;
  wire                output_fire;
  reg                 t_output_payload;
  reg        [6:0]    t_output_payload_1;
  reg        [6:0]    t_output_payload_2;
  wire                t_input_ready;
  wire       [2047:0] t_output_payload_3;

  assign t_t_output_payload_1_1 = t_output_payload;
  assign t_t_output_payload_1 = {6'd0, t_t_output_payload_1_1};
  always @(*) begin
    case(t_output_payload_2)
      7'b0000000 : t_output_payload_4 = t_output_payload_3[15 : 0];
      7'b0000001 : t_output_payload_4 = t_output_payload_3[31 : 16];
      7'b0000010 : t_output_payload_4 = t_output_payload_3[47 : 32];
      7'b0000011 : t_output_payload_4 = t_output_payload_3[63 : 48];
      7'b0000100 : t_output_payload_4 = t_output_payload_3[79 : 64];
      7'b0000101 : t_output_payload_4 = t_output_payload_3[95 : 80];
      7'b0000110 : t_output_payload_4 = t_output_payload_3[111 : 96];
      7'b0000111 : t_output_payload_4 = t_output_payload_3[127 : 112];
      7'b0001000 : t_output_payload_4 = t_output_payload_3[143 : 128];
      7'b0001001 : t_output_payload_4 = t_output_payload_3[159 : 144];
      7'b0001010 : t_output_payload_4 = t_output_payload_3[175 : 160];
      7'b0001011 : t_output_payload_4 = t_output_payload_3[191 : 176];
      7'b0001100 : t_output_payload_4 = t_output_payload_3[207 : 192];
      7'b0001101 : t_output_payload_4 = t_output_payload_3[223 : 208];
      7'b0001110 : t_output_payload_4 = t_output_payload_3[239 : 224];
      7'b0001111 : t_output_payload_4 = t_output_payload_3[255 : 240];
      7'b0010000 : t_output_payload_4 = t_output_payload_3[271 : 256];
      7'b0010001 : t_output_payload_4 = t_output_payload_3[287 : 272];
      7'b0010010 : t_output_payload_4 = t_output_payload_3[303 : 288];
      7'b0010011 : t_output_payload_4 = t_output_payload_3[319 : 304];
      7'b0010100 : t_output_payload_4 = t_output_payload_3[335 : 320];
      7'b0010101 : t_output_payload_4 = t_output_payload_3[351 : 336];
      7'b0010110 : t_output_payload_4 = t_output_payload_3[367 : 352];
      7'b0010111 : t_output_payload_4 = t_output_payload_3[383 : 368];
      7'b0011000 : t_output_payload_4 = t_output_payload_3[399 : 384];
      7'b0011001 : t_output_payload_4 = t_output_payload_3[415 : 400];
      7'b0011010 : t_output_payload_4 = t_output_payload_3[431 : 416];
      7'b0011011 : t_output_payload_4 = t_output_payload_3[447 : 432];
      7'b0011100 : t_output_payload_4 = t_output_payload_3[463 : 448];
      7'b0011101 : t_output_payload_4 = t_output_payload_3[479 : 464];
      7'b0011110 : t_output_payload_4 = t_output_payload_3[495 : 480];
      7'b0011111 : t_output_payload_4 = t_output_payload_3[511 : 496];
      7'b0100000 : t_output_payload_4 = t_output_payload_3[527 : 512];
      7'b0100001 : t_output_payload_4 = t_output_payload_3[543 : 528];
      7'b0100010 : t_output_payload_4 = t_output_payload_3[559 : 544];
      7'b0100011 : t_output_payload_4 = t_output_payload_3[575 : 560];
      7'b0100100 : t_output_payload_4 = t_output_payload_3[591 : 576];
      7'b0100101 : t_output_payload_4 = t_output_payload_3[607 : 592];
      7'b0100110 : t_output_payload_4 = t_output_payload_3[623 : 608];
      7'b0100111 : t_output_payload_4 = t_output_payload_3[639 : 624];
      7'b0101000 : t_output_payload_4 = t_output_payload_3[655 : 640];
      7'b0101001 : t_output_payload_4 = t_output_payload_3[671 : 656];
      7'b0101010 : t_output_payload_4 = t_output_payload_3[687 : 672];
      7'b0101011 : t_output_payload_4 = t_output_payload_3[703 : 688];
      7'b0101100 : t_output_payload_4 = t_output_payload_3[719 : 704];
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
      7'b1011111 : t_output_payload_4 = t_output_payload_3[1535 : 1520];
      7'b1100000 : t_output_payload_4 = t_output_payload_3[1551 : 1536];
      7'b1100001 : t_output_payload_4 = t_output_payload_3[1567 : 1552];
      7'b1100010 : t_output_payload_4 = t_output_payload_3[1583 : 1568];
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
