lu121314/llama_acc/(commit log)

2026-11-03 202611032206新增skill，prompt，doc
2026-11-03 补充文档
2026-11-03 修改版doc
